b-gong/jam-pad/FreeCad/top_case - new.FCStd

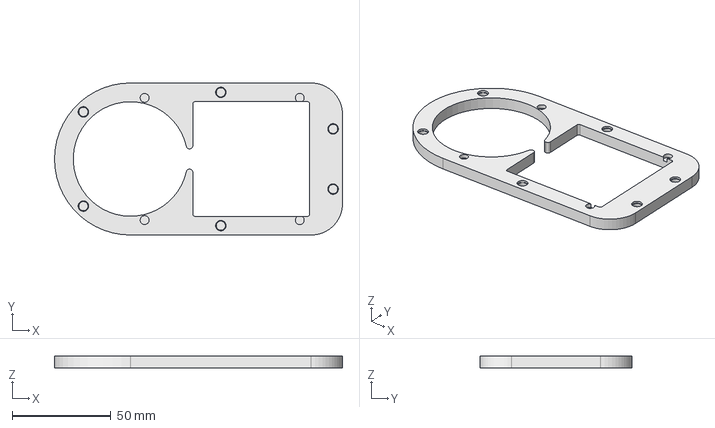
[picture p1: CAD file, 2023-10-24]
FreeCad/top_case - new.FCStd
145.9 x 77.0 x 6.00 mm
