b-gong/jam-pad/KiCad/jam-pad-plate/footprints/3dmodels/Display_Waveshare_OLED_1.5inch_128x128.stp

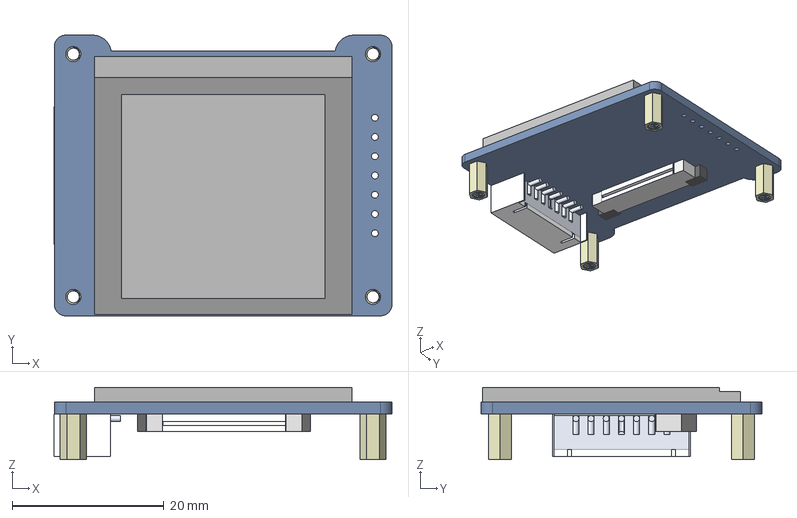
[picture p2: CAD file, 2022-12-26]
KiCad/jam-pad-plate/footprints/3dmodels/Display_Waveshare_OLED_1.5inch_128x128.stp
44.5 x 37.0 x 9.50 mm
1_5INCH-RGB-OLED
1_5INCH_OLED_RGB_PCBA
M2XH6_COPPER-POST x 4
