b-gong/jam-pad/KiCad/jam-pad-plate/footprints/Keebio-Parts.pretty-master/3dmodels/PJ-320A.step

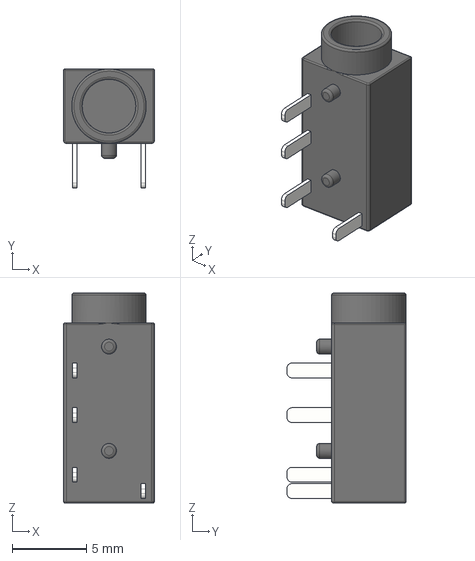
[picture p3: CAD file, 2022-10-30]
KiCad/jam-pad-plate/footprints/Keebio-Parts.pretty-master/3dmodels/PJ-320A.step
6.10 x 8.00 x 14.1 mm
