b-gong/jam-pad/KiCad/jam-pad/3D_models/PEC11H-4215F-S0024.stp

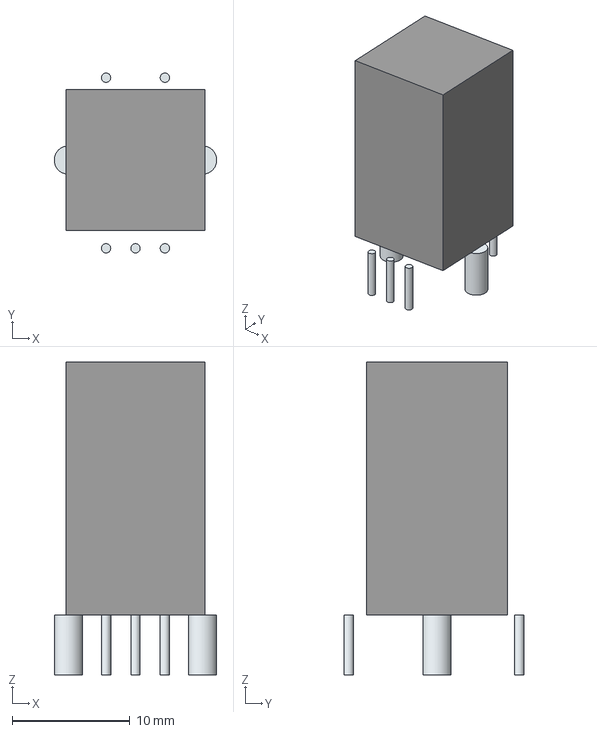
[picture p4: CAD file, 2023-09-24]
KiCad/jam-pad/3D_models/PEC11H-4215F-S0024.stp
13.8 x 15.3 x 26.6 mm
Leads x 7
