b-gong/jam-pad/misc/plate_switches.dxf

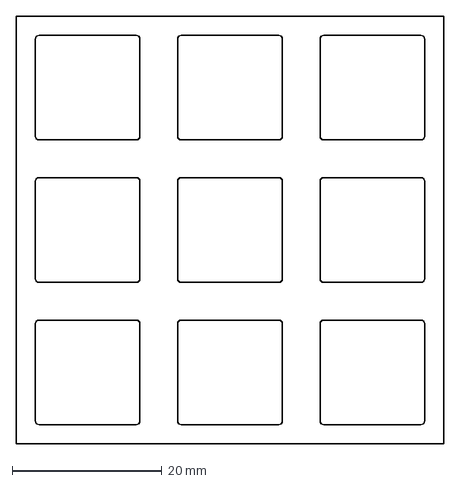
[picture p5: CAD file, 2023-04-23]
misc/plate_switches.dxf
57.1 x 57.1 mm
