b-gong/jam-pad/KiCad/jam-pad-plate/footprints/Keebio-Parts.pretty-master/3dmodels/SK6812MINI-E v1.step

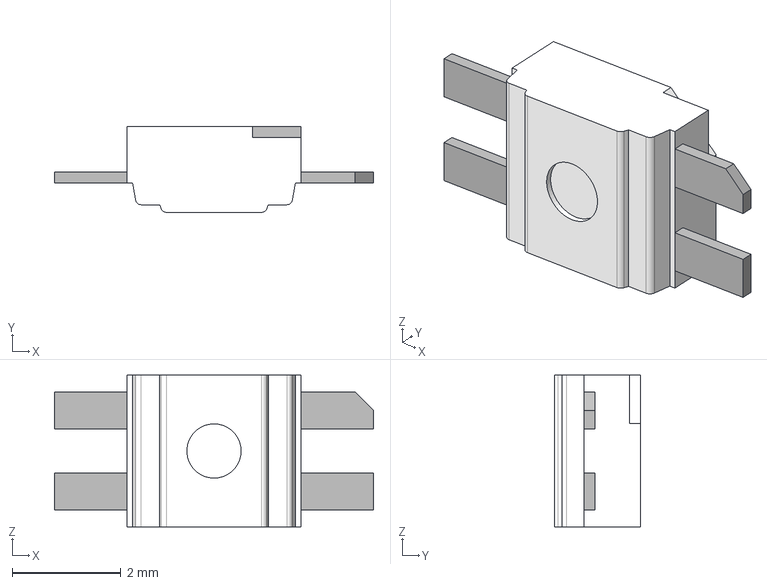
[picture p6: CAD file, 2022-10-30]
KiCad/jam-pad-plate/footprints/Keebio-Parts.pretty-master/3dmodels/SK6812MINI-E v1.step
5.88 x 1.58 x 2.80 mm
