b-gong/jam-pad/FreeCad/BrandonGong_JamBotCase_Ver2.stl

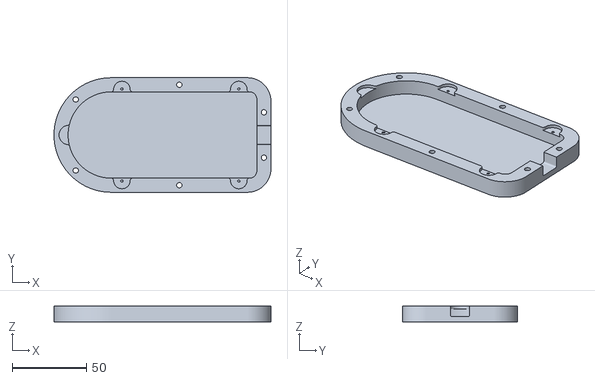
[picture p7: CAD file, 2023-10-24]
FreeCad/BrandonGong_JamBotCase_Ver2.stl
145.8 x 77.0 x 10.5
