b-gong/jam-pad/KiCad/jam-pad-plate/footprints/Keebio-Parts.pretty-master/3dmodels/HRO  TYPE-C-31-M-12.step

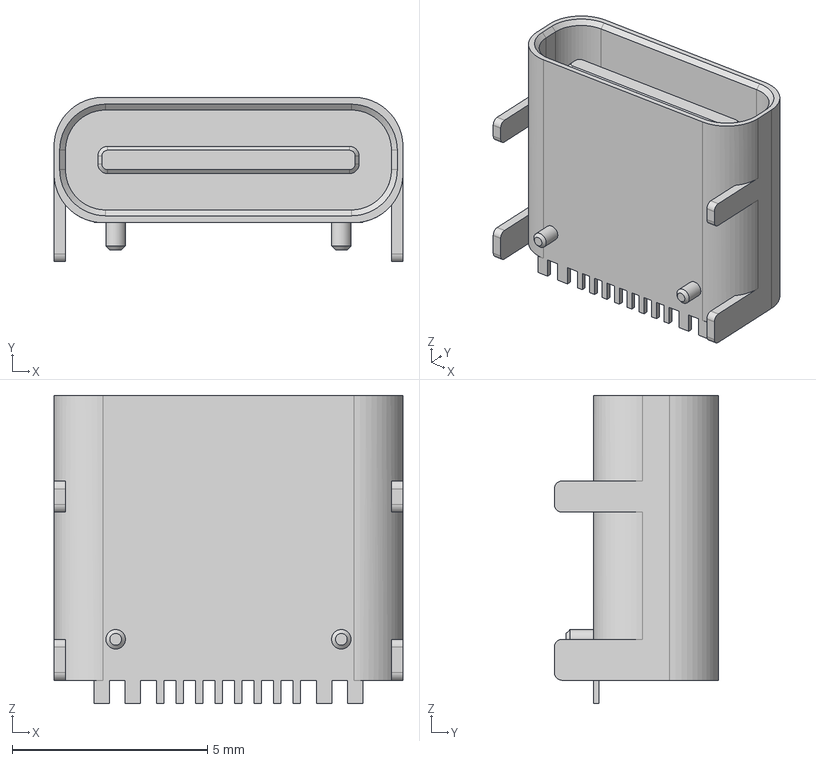
[picture p8: CAD file, 2022-10-30]
KiCad/jam-pad-plate/footprints/Keebio-Parts.pretty-master/3dmodels/HRO TYPE-C-31-M-12.step
8.94 x 4.21 x 7.90 mm
