b-gong/jam-pad/KiCad/jam-pad-plate/footprints/Keebio-Parts.pretty-master/3dmodels/CUI_SJ-43614-SMT-TR.step

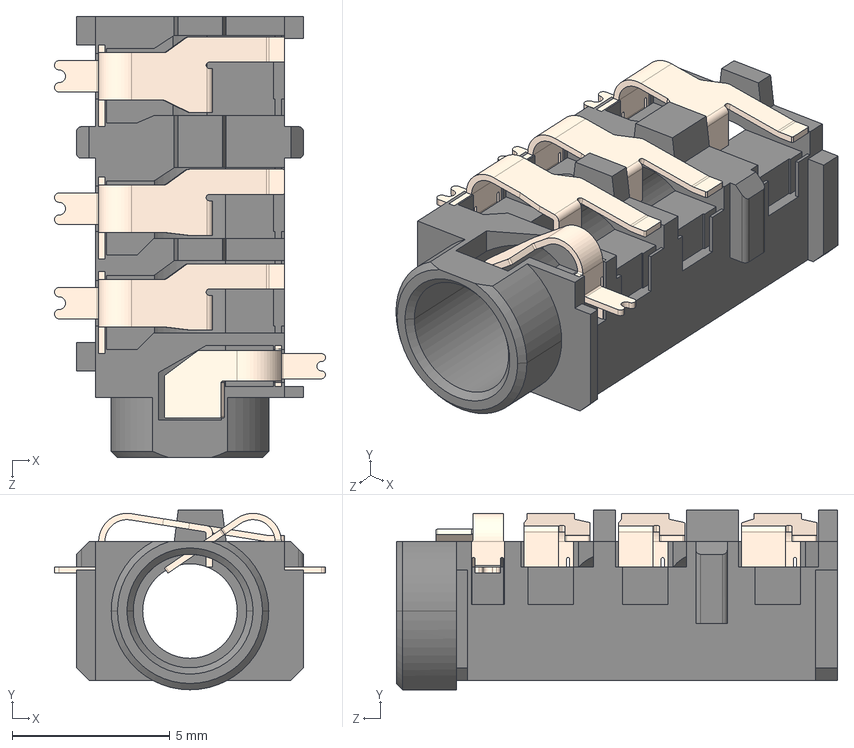
[picture p9: CAD file, 2022-10-30]
KiCad/jam-pad-plate/footprints/Keebio-Parts.pretty-master/3dmodels/CUI_SJ-43614-SMT-TR.step
8.60 x 5.70 x 14.0 mm
