b-gong/jam-pad/FreeCad/BrandonGong_JamKnob_Ver2.stl

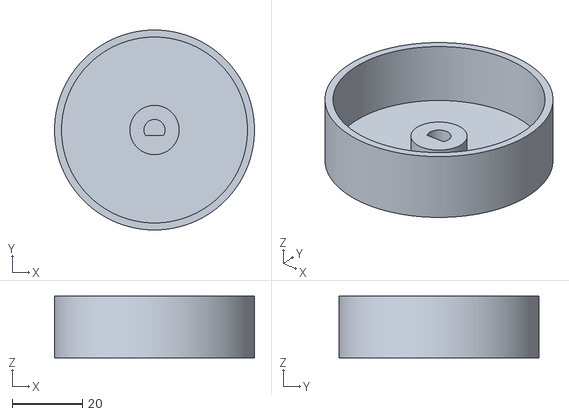
[picture p10: CAD file, 2023-10-11]
FreeCad/BrandonGong_JamKnob_Ver2.stl
56.8 x 56.8 x 17.5
