b-gong/jam-pad/FreeCad/bottom_case.FCStd

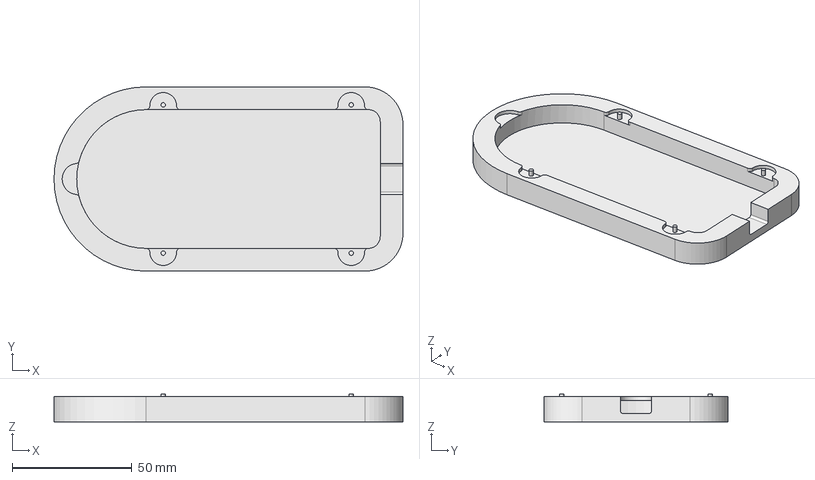
[picture p11: CAD file, 2023-09-24]
FreeCad/bottom_case.FCStd
145.9 x 77.0 x 11.5 mm
