b-gong/jam-pad/FreeCad/top_case.FCStd

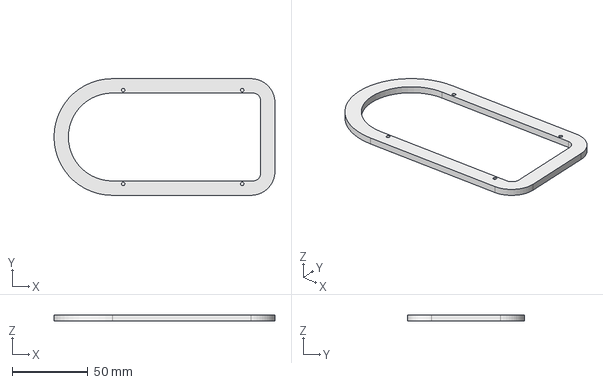
[picture p12: CAD file, 2023-09-24]
FreeCad/top_case.FCStd
145.9 x 77.0 x 4.00 mm
