b-gong/jam-pad/FreeCad/hole_test.stl

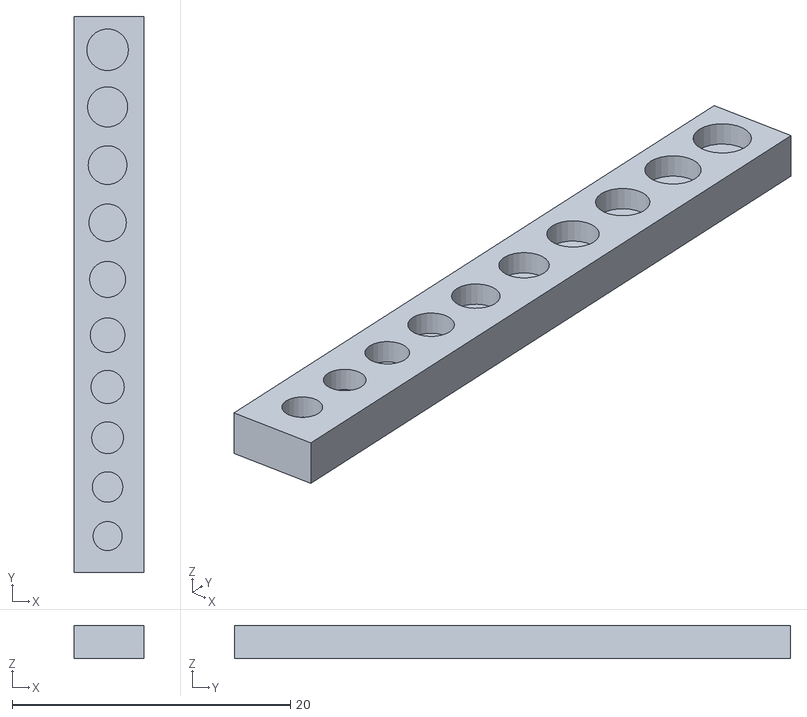
[picture p13: CAD file, 2023-09-24]
FreeCad/hole_test.stl
5.00 x 40.0 x 2.40
