b-gong/jam-pad/(list of files, cad)

Other CAD files:
FreeCad/assembly.FCStd
FreeCad/BrandonGong_JamTopCase_Ver2.stl
FreeCad/bottom_case - new.FCStd
FreeCad/knob.FCStd
FreeCad/BrandonGong_JamBotCase_Ver1.stl
FreeCad/BrandonGong_JamKnob_Ver1.stl
FreeCad/BrandonGong_JamTopCase_Ver1.stl
