b-gong/jam-pad/KiCad/jam-pad/jam-pad.kicad_pcb

## KiCad design KiCad/jam-pad/jam-pad.kicad_pcb (2023-09-24)

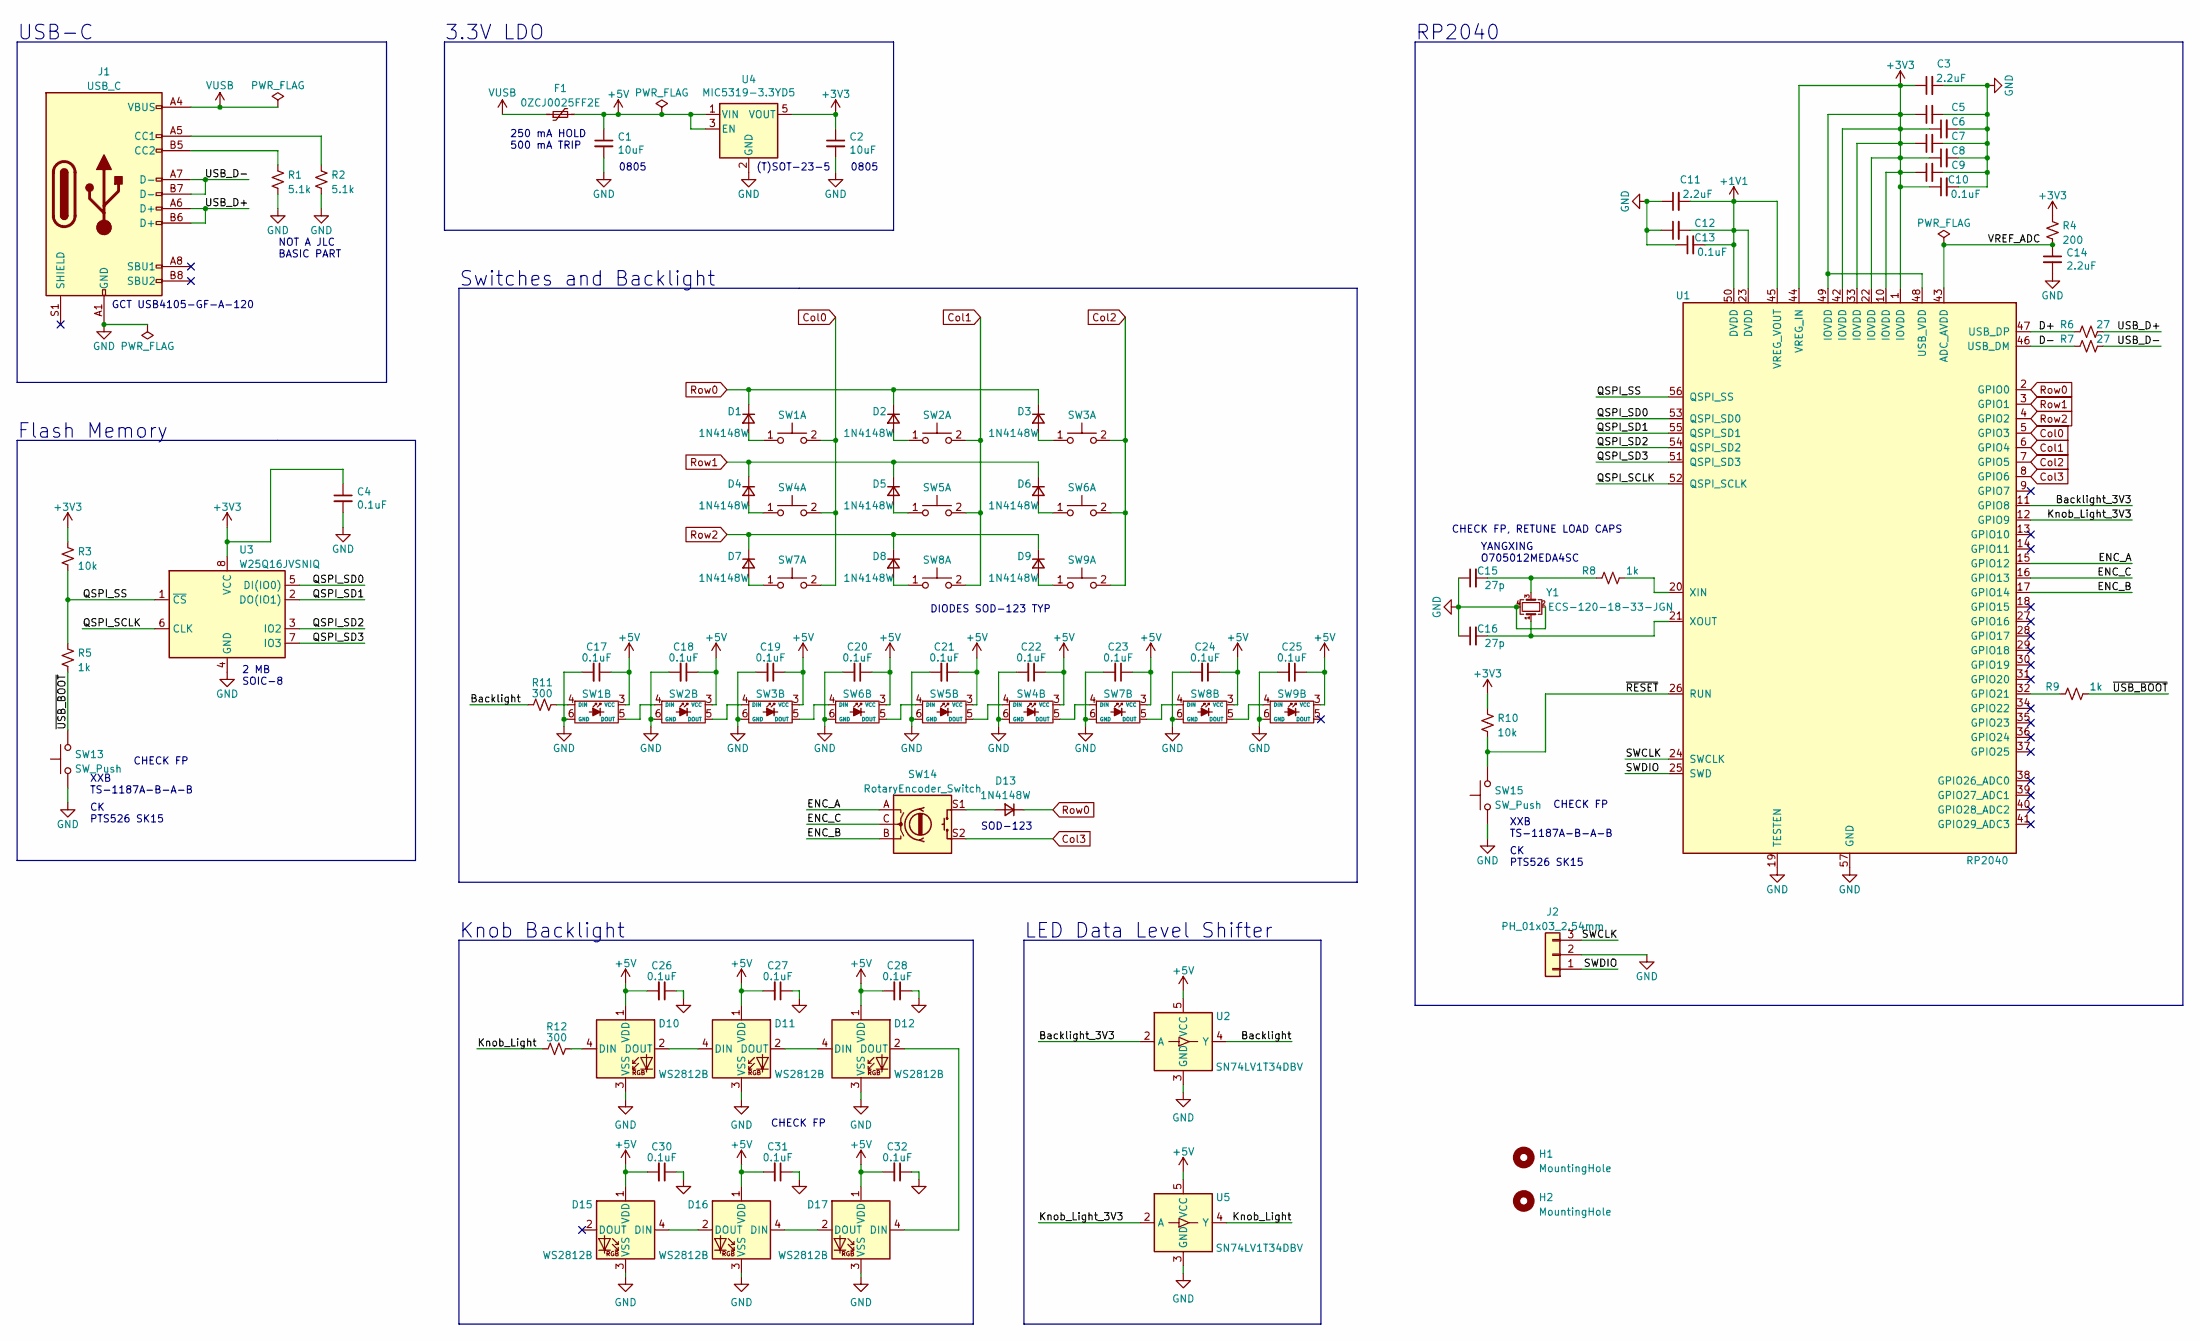
[picture p14: schematic jam-pad.kicad_sch, JamPad]

Parts:
C1, C2: 10uF; C_0805_2012Metric_Pad1.18x1.45mm_HandSolder; LCSC C19702
C3, C11, C14: 2.2uF; C_0603_1608Metric_Pad1.08x0.95mm_HandSolder; LCSC C23630
C4, C5, C6, C7, C8, C9, C10, C12, C13, C17, C18, C19, C20, C21, C22, C23, C24, C25, C26, C27, C28, C30, C31, C32: 0.1uF; C_0603_1608Metric_Pad1.08x0.95mm_HandSolder; LCSC C107045
C15, C16: 27p; C_0603_1608Metric_Pad1.08x0.95mm_HandSolder; LCSC C14663
D1, D2, D3, D4, D5, D6, D7, D8, D9, D13: 1N4148W; D_SOD-123; LCSC C81598
D10, D11, D12, D15, D16, D17: WS2812B; LED_WS2812B_PLCC4_5.0x5.0mm_P3.2mm; LCSC C2761795
F1: 0ZCJ0025FF2E; Fuse_1206_3216Metric_Pad1.42x1.75mm_HandSolder; JLCPCB_IGNORE Y
H1, H2: MountingHole; MountingHole_2.2mm_M2_Pad; JLCPCB_IGNORE Y
J1: USB_C; USB_C_Receptacle_GCT_USB4105-GF-A-120; JLCPCB_IGNORE Y
J2: PH_01x03_2.54mm; PinHeader_1x03_P2.54mm_NoSilk; JLCPCB_IGNORE Y
R1, R2: 5.1k; R_0603_1608Metric_Pad0.98x0.95mm_HandSolder; JLCPCB_IGNORE Y
R3, R10: 10k; R_0603_1608Metric_Pad0.98x0.95mm_HandSolder; LCSC C25804
R4: 200; R_0603_1608Metric_Pad0.98x0.95mm_HandSolder; LCSC C8218
R5, R8, R9: 1k; R_0603_1608Metric_Pad0.98x0.95mm_HandSolder; LCSC C21190
R6, R7: 27; R_0603_1608Metric_Pad0.98x0.95mm_HandSolder; LCSC C25190
R11, R12: 300; R_0603_1608Metric_Pad0.98x0.95mm_HandSolder; LCSC C23025
SW1, SW2, SW3, SW7, SW8, SW9: MX_Hotswap_LED_RGB; MXOnly-1U-Hotswap-SK6812MINI-E_180; JLCPCB_IGNORE Y
SW4, SW5, SW6: MX_Hotswap_LED_RGB; MXOnly-1U-Hotswap-SK6812MINI-E; JLCPCB_IGNORE Y
SW13, SW15: SW_Push; SW_Push_PTS526; LCSC C318884
SW14: RotaryEncoder_Switch; PEC11; JLCPCB_IGNORE Y
U1: RP2040; RP2040-QFN-56; LCSC C2040
U2, U5: SN74LV1T34DBV; SOT-23-5; LCSC C100024
U3: W25Q16JVSNIQ; SOIC-8_3.9x4.9mm_P1.27mm; LCSC C2456211
U4: MIC5319-3.3YD5; SOT-23-5; JLCPCB_IGNORE Y
Y1: ECS-120-18-33-JGN; Crystal_SMD_SeikoEpson_FA238-4Pin_3.2x2.5mm; LCSC C15918

Connections:
+1V1: C11.2, C12.2, C13.2, U1.23 (DVDD), U1.45 (VREG_VOUT), U1.50 (DVDD)
+3V3: C2.1, C3.1, C4.1, C5.1, C6.1, C7.1, C8.1, C9.1, C10.1, R3.1, R4.1, R10.1, U1.1 (IOVDD), U1.10 (IOVDD), U1.22 (IOVDD), U1.33 (IOVDD), U1.42 (IOVDD), U1.44 (VREG_IN), U1.48 (USB_VDD), U1.49 (IOVDD), U3.8 (VCC), U4.5 (VOUT)
+5V: C1.1, C17.1, C18.1, C19.1, C20.1, C21.1, C22.1, C23.1, C24.1, C25.1, C26.2, C27.2, C28.2, C30.2, C31.2, C32.2, D10.1 (VDD), D11.1 (VDD), D12.1 (VDD), D15.1 (VDD), D16.1 (VDD), D17.1 (VDD), F1.2, SW1.3 (VCC), SW2.3 (VCC), SW3.3 (VCC), SW4.3 (VCC), SW5.3 (VCC), SW6.3 (VCC), SW7.3 (VCC), SW8.3 (VCC), SW9.3 (VCC), U2.5 (VCC), U4.1 (VIN), U4.3 (EN), U5.5 (VCC)
/Backlight: R11.1, U2.4 (Y)
/Backlight_3V3: U1.11 (GPIO8), U2.2 (A)
/D+: R6.1, U1.47 (USB_DP)
/D-: R7.1, U1.46 (USB_DM)
/ENC_A: SW14.A, U1.15 (GPIO12)
/ENC_B: SW14.B, U1.17 (GPIO14)
/ENC_C: SW14.C, U1.16 (GPIO13)
/Knob_Light: R12.1, U5.4 (Y)
/Knob_Light_3V3: U1.12 (GPIO9), U5.2 (A)
/QSPI_SCLK: U1.52 (QSPI_SCLK), U3.6 (CLK)
/QSPI_SD0: U1.53 (QSPI_SD0), U3.5 (DI(IO0))
/QSPI_SD1: U1.55 (QSPI_SD1), U3.2 (DO(IO1))
/QSPI_SD2: U1.54 (QSPI_SD2), U3.3 (IO2)
/QSPI_SD3: U1.51 (QSPI_SD3), U3.7 (IO3)
/QSPI_SS: R3.2, R5.1, U1.56 (QSPI_SS), U3.1 (~CS)
/SWCLK: J2.3, U1.24 (SWCLK)
/SWDIO: J2.1, U1.25 (SWD)
/USB_D+: J1.A6 (D+), J1.B6 (D+), R6.2
/USB_D-: J1.A7 (D-), J1.B7 (D-), R7.2
/VREF_ADC: C14.1, R4.2, U1.43 (ADC_AVDD)
/~RESET: R10.2, SW15.2, U1.26 (RUN)
/~USB_BOOT: R5.2, R9.2, SW13.2
Col0: SW1.2, SW4.2, SW7.2, U1.5 (GPIO3)
Col1: SW2.2, SW5.2, SW8.2, U1.6 (GPIO4)
Col2: SW3.2, SW6.2, SW9.2, U1.7 (GPIO5)
Col3: SW14.S2, U1.8 (GPIO6)
GND: C1.2, C2.2, C3.2, C4.2, C5.2, C6.2, C7.2, C8.2, C9.2, C10.2, C11.1, C12.1, C13.1, C14.2, C15.1, C16.1, C17.2, C18.2, C19.2, C20.2, C21.2, C22.2, C23.2, C24.2, C25.2, C26.1, C27.1, C28.1, C30.1, C31.1, C32.1, D10.3 (VSS), D11.3 (VSS), D12.3 (VSS), D15.3 (VSS), D16.3 (VSS), D17.3 (VSS), J1.A1 (GND), J1.A12 (GND), J1.B1 (GND), J1.B12 (GND), J2.2, R1.2, R2.2, SW1.6 (GND), SW2.6 (GND), SW3.6 (GND), SW4.6 (GND), SW5.6 (GND), SW6.6 (GND), SW7.6 (GND), SW8.6 (GND), SW9.6 (GND), SW13.1, SW15.1, U1.19 (TESTEN), U1.57 (GND), U2.3 (GND), U3.4 (GND), U4.2 (GND), U5.3 (GND), Y1.2, Y1.4
unnamed: C15.2, R8.1, Y1.3
unnamed: D1.2 (A), SW1.1
unnamed: D2.2 (A), SW2.1
unnamed: D3.2 (A), SW3.1
unnamed: D4.2 (A), SW4.1
unnamed: D5.2 (A), SW5.1
unnamed: D6.2 (A), SW6.1
unnamed: D7.2 (A), SW7.1
unnamed: D8.2 (A), SW8.1
unnamed: D9.2 (A), SW9.1
unnamed: D10.4 (DIN), R12.2
unnamed: D10.2 (DOUT), D11.4 (DIN)
unnamed: D11.2 (DOUT), D12.4 (DIN)
unnamed: D12.2 (DOUT), D17.4 (DIN)
unnamed: D13.2 (A), SW14.S1
unnamed: D15.4 (DIN), D16.2 (DOUT)
unnamed: D16.4 (DIN), D17.2 (DOUT)
unnamed: J1.A5 (CC1), R2.1
unnamed: J1.B5 (CC2), R1.1
unnamed: R11.2, SW1.4 (DIN)
unnamed: SW1.5 (DOUT), SW2.4 (DIN)
unnamed: SW2.5 (DOUT), SW3.4 (DIN)
unnamed: SW3.5 (DOUT), SW6.4 (DIN)
unnamed: SW4.4 (DIN), SW5.5 (DOUT)
unnamed: SW4.5 (DOUT), SW7.4 (DIN)
unnamed: SW5.4 (DIN), SW6.5 (DOUT)
unnamed: SW7.5 (DOUT), SW8.4 (DIN)
unnamed: SW8.5 (DOUT), SW9.4 (DIN)
unnamed: R9.1, U1.32 (GPIO21)
unnamed: R8.2, U1.20 (XIN)
unnamed: C16.2, U1.21 (XOUT), Y1.1
Row0: D1.1 (K), D2.1 (K), D3.1 (K), D13.1 (K), U1.2 (GPIO0)
Row1: D4.1 (K), D5.1 (K), D6.1 (K), U1.3 (GPIO1)
Row2: D7.1 (K), D8.1 (K), D9.1 (K), U1.4 (GPIO2)
VUSB: F1.1, J1.A4 (VBUS), J1.A9 (VBUS), J1.B4 (VBUS), J1.B9 (VBUS)

Notes on the sheet:
2 MB SOIC-8
(T)SOT-23-5
CK PTS526 SK15
GCT USB4105-GF-A-120
DIODES SOD-123 TYP
250 mA HOLD 500 mA TRIP
Knob Backlight
NOT A JLC BASIC PART
CHECK FP
Switches and Backlight
USB-C
Flash Memory
XXB TS-1187A-B-A-B
3.3V LDO
LED Data Level Shifter
YANGXING O705012MEDA4SC
0805
RP2040
CHECK FP, RETUNE LOAD CAPS
SOD-123

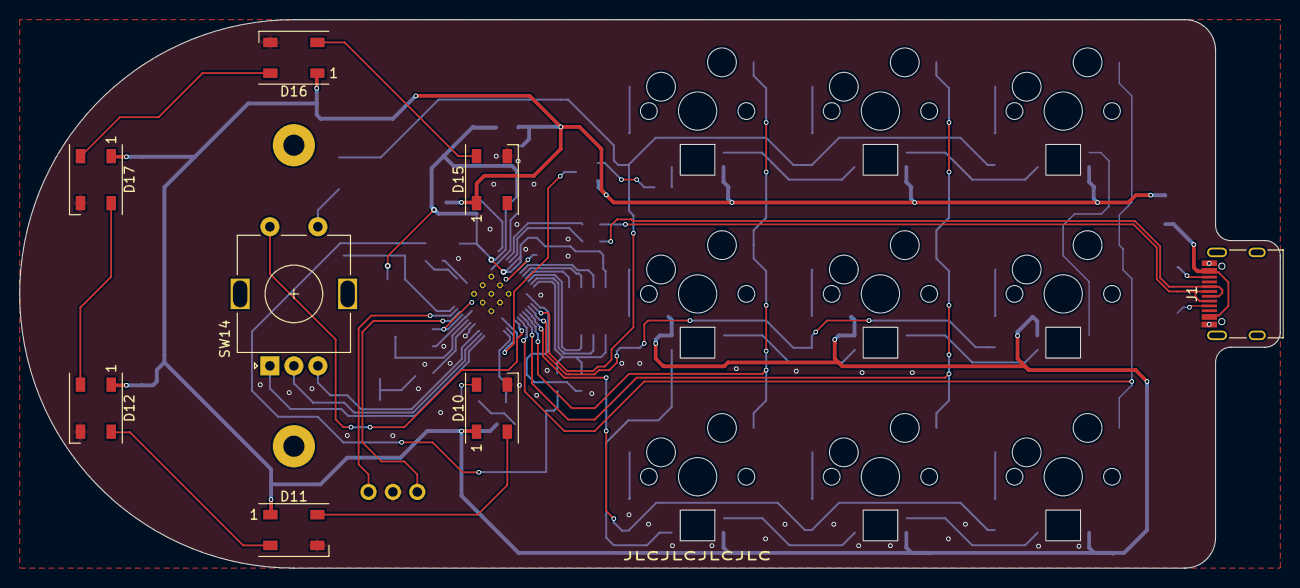
[picture p15: board jam-pad.kicad_pcb from above]

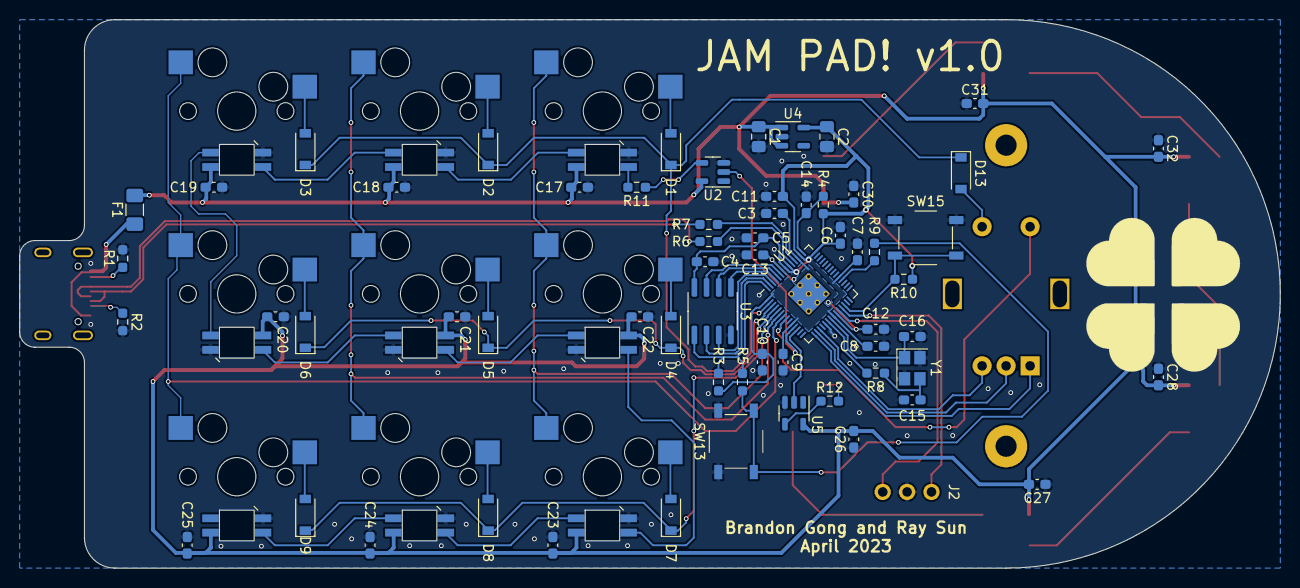
[picture p16: board jam-pad.kicad_pcb from below]

Board: 2 copper layers, 131.4 x 57.1 mm, 83 parts (64 on the bottom side), 65 nets.

Other parts of the board:
Ref**: Val**; cloverlogo
