b-gong/jam-pad/firmware/keyboards/jampad/keymaps/vial/config.h

#pragma once

#define VIAL_KEYBOARD_UID {0x03, 0x08, 0xA0, 0x1D, 0x38, 0x7C, 0xD7, 0x12}

// Vial unlock combo: hold physical 1 + 9.
#define VIAL_UNLOCK_COMBO_ROWS {0, 2}
#define VIAL_UNLOCK_COMBO_COLS {0, 2}
