b-gong/jam-pad/(commit log)

2022-10-30 created project, added basic stuff + jackrabbit rp2040
    [CUI_SJ-43614-SMT-TR.step, HRO TYPE-C-31-M-12.step, PJ-320A.step, SK6812MINI-E v1.step, jam-pad.kicad_pcb, jam-pad.kicad_sch]
2022-12-26 update gitignore, some unknown schematic changes
    [jam-pad.kicad_sch]
2022-12-26 Assign footprints
    [Display_Waveshare_OLED_1.5inch_128x128.stp, jam-pad.kicad_sch]
2022-12-27 mx_only fp lib and replace switch footprints
    [jam-pad.kicad_sch]
2022-12-27 Make multi-unit fooprint for MX key with RGB LED
2022-12-27 Clean up symbol dependencies and pass ERC with schematic so far
    [jam-pad.kicad_sch]
2023-01-14 added jlc part datasheets (cap, res, 1n4148, rp2040)
    [jam-pad.kicad_sch]
2023-01-17 initial layout
    [jam-pad.kicad_pcb, jam-pad.kicad_sch]
2023-01-17 moved d13 to bottom
    [jam-pad.kicad_pcb]
2023-02-01 12 to 9 keys
    [jam-pad.kicad_pcb, jam-pad.kicad_sch]
2023-02-01 Place MCU parts
    [jam-pad.kicad_pcb]
2023-02-02 add reverse mounted sk6812/ws2812 fp
2023-03-17 added multi part sym for switch+led, remove backups
    [jam-pad.kicad_pcb, jam-pad.kicad_sch]
2023-03-17 Add JLCPCB design rules and preliminary route MCU
    [jam-pad.kicad_pcb]
2023-03-29 changed underglow to knoblight, added led c and r, placed leds
    [jam-pad.kicad_pcb, jam-pad.kicad_sch]
2023-03-29 knob leds moved to top
    [jam-pad.kicad_pcb]
2023-04-01 initial routing
    [jam-pad.kicad_pcb, jam-pad.kicad_sch]
2023-04-03 idk how to route + forgot to put flipped led switch fp in
    [jam-pad.kicad_pcb]
2023-04-21 mcu placing + routing, power LED on 5V and level shifter
    [jam-pad.kicad_pcb, jam-pad.kicad_sch]
2023-04-22 Add symbol fields for KiKit
    [jam-pad.kicad_sch]
2023-04-22 bit of power routing
    [jam-pad.kicad_pcb]
2023-04-22 finished everything besides ground preliminarily
    [jam-pad.kicad_pcb]
2023-04-23 initial plate stuff
    [jam-pad.kicad_pcb, jam-pad_plate.kicad_pcb, plate_switches.dxf]
2023-04-26 routing adjustments, ec11 standoff, need to fix drc kms
    [jam-pad.kicad_pcb, jam-pad.kicad_sch, jam-pad_plate.kicad_pcb]
2023-04-27 some more routing adjustments, move plate to its own folder. should be done besides footprint drc errors, deco, maybe replace rp2040 fp
    [CUI_SJ-43614-SMT-TR.step, Display_Waveshare_OLED_1.5inch_128x128.stp, HRO TYPE-C-31-M-12.step, PJ-320A.step, SK6812MINI-E v1.step, jam-pad.kicad_pcb, jam-pad_plate.kicad_pcb]
2023-04-27 Remove unconnected tracks and pass schematic parity
    [jam-pad.kicad_pcb, jam-pad.kicad_sch]
2023-04-27 fix up usb_boot; bare minimum gnd vias; fix silkscreen overlap
    [jam-pad.kicad_pcb]
2023-05-07 Add simple key matrix test code, USB printf
2023-05-10 fab, clover logo, some other stuff? idr sorry
    [jam-pad-CmtUser.gbr, jam-pad-CuBottom.gbl, jam-pad-CuTop.gtl, jam-pad-EdgeCuts.gm1, jam-pad-MaskBottom.gbs, jam-pad-MaskTop.gts, jam-pad-PasteBottom.gbp, jam-pad-PasteTop.gtp]
2023-09-24 outdated case, updated pec11
    [PEC11H-4215F-S0024.stp, basic dimensions.FCStd, bottom_case.FCStd, bottom_case.stl, hole_test.stl, jam-pad.kicad_pcb, jam-pad.kicad_sch, top_case.FCStd]
2023-09-29 renmae ver1 files
    [BrandonGong_JamBotCase_Ver1.stl, BrandonGong_JamKnob_Ver1.stl, BrandonGong_JamTopCase_Ver1.stl]
2023-09-29 some ver2 fixes, not done yet
    [BrandonGong_JamKnob_Ver2.stl, BrandonGong_JamTopCase_Ver2.stl, knob.FCStd, top_case - new.FCStd]
2023-10-11 v2 models
    [BrandonGong_JamBotCase_Ver2.stl, BrandonGong_JamKnob_Ver2.stl, BrandonGong_JamTopCase_Ver2.stl, bottom_case - new.FCStd, top_case - new.FCStd]
